gmelodie/fire-lora-heltec/figures/deployment_map.png

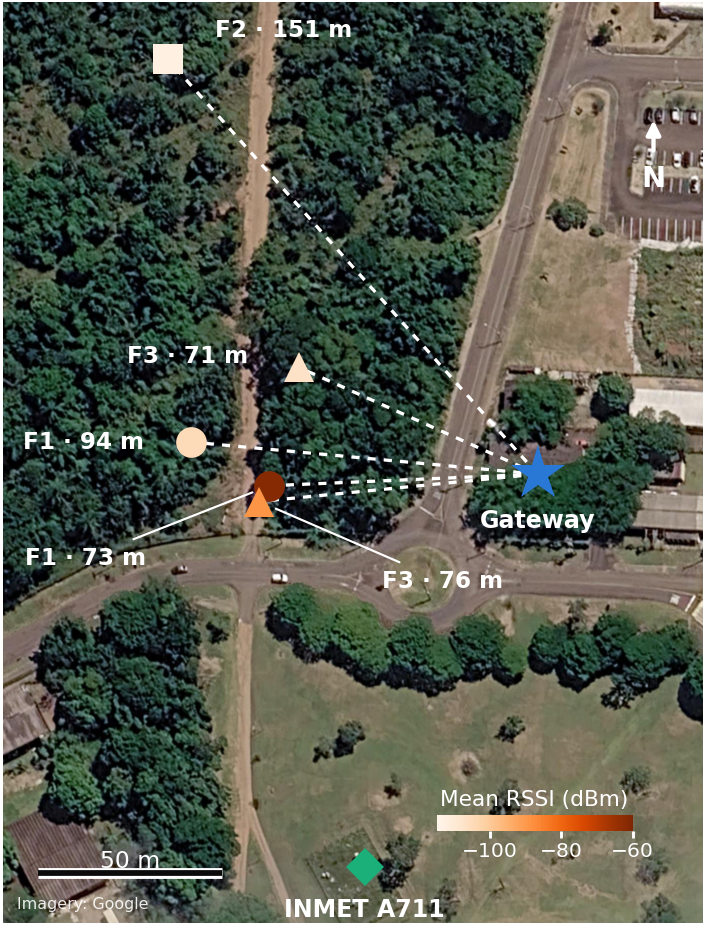
figures/deployment_map.png
