gmelodie/fire-lora-heltec/figures/battery_discharge.png

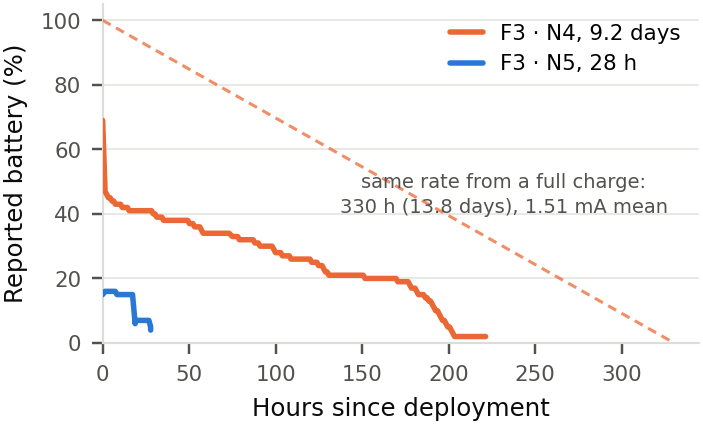
figures/battery_discharge.png
