gmelodie/fire-lora-heltec/figures/condensation_cycle.png

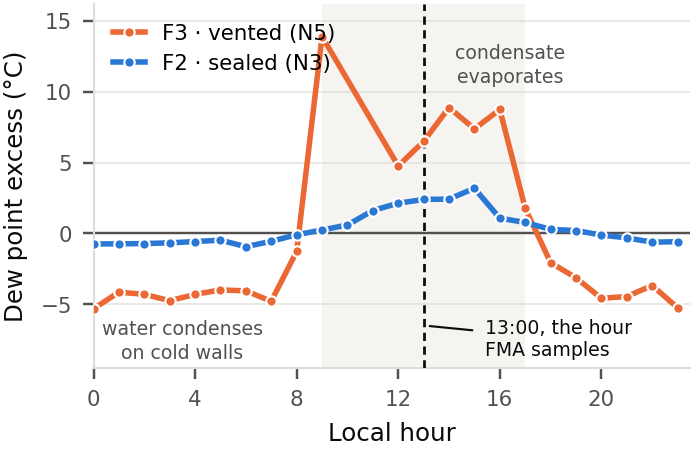
figures/condensation_cycle.png
