gmelodie/fire-lora-heltec/figures/fma_season.png

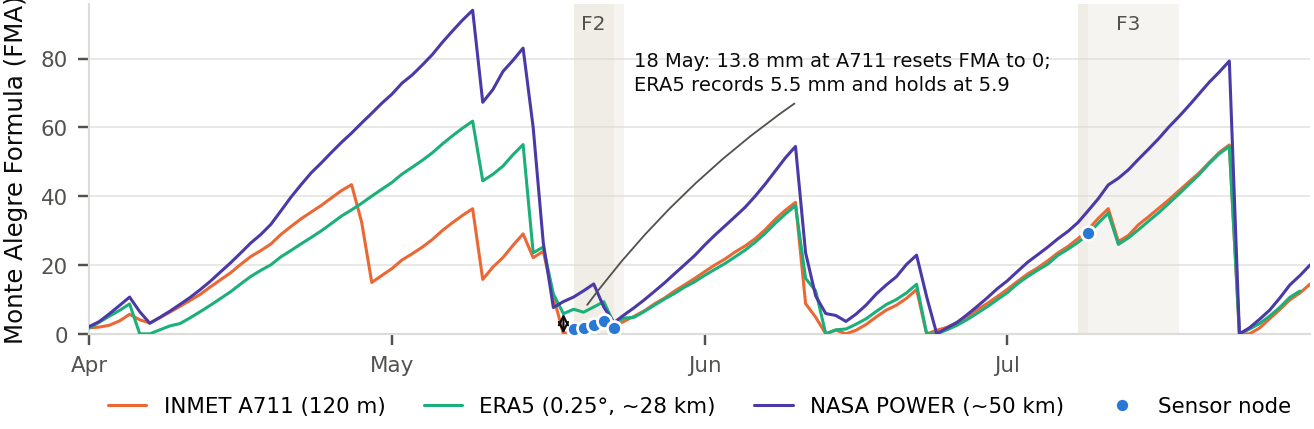
figures/fma_season.png
