gmelodie/fire-lora-heltec/figures/index_ladder.png

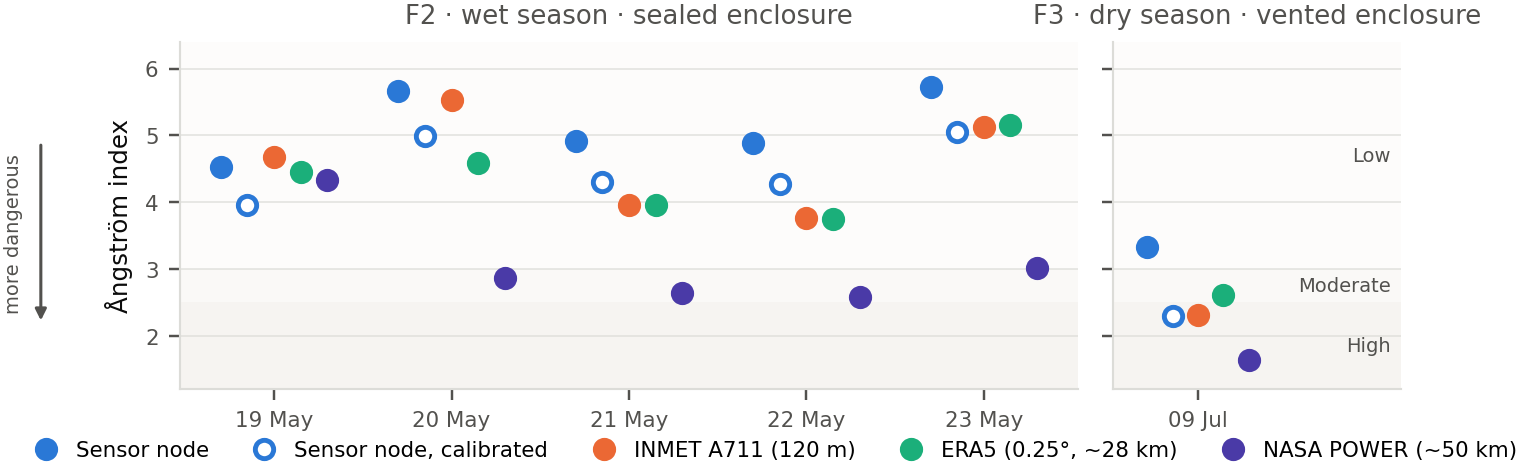
figures/index_ladder.png
