gmelodie/fire-lora-heltec/figures/link_budget.png

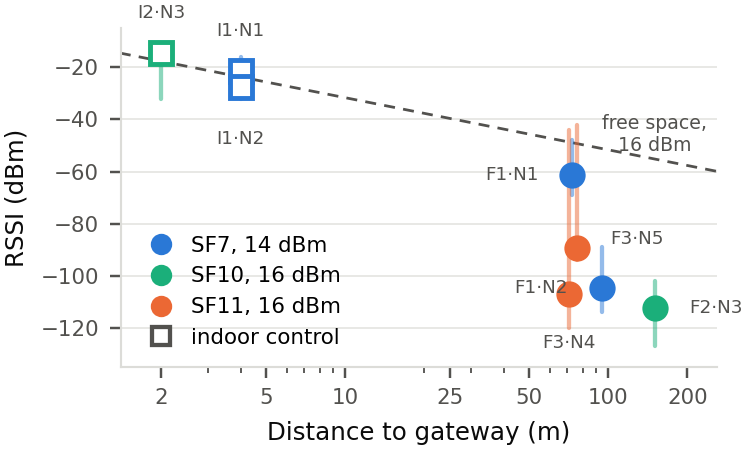
figures/link_budget.png
