gmelodie/fire-lora-heltec/(commit log)

2026-02-28 add battery module
2026-03-01 chore: update to v3 board
2026-03-17 fix(sensor): fix battery reading
    - Swap voltage formula for empirical ADC thresholds
    - Add BAT_100..BAT_DEAD and NUM_ADC_SAMPLES to settings.h
    - Changed BATTERY_PIN 17 -> 1
    [sensor.ino, settings.h]
2026-03-17 fix(sensor): fix BME280 I2C initialization
    - Use Wire1 to avoid conflict with OLED on default Wire bus
    - Add BME_SDA (4) and BME_SCL (3) to settings.h
    - Pass &Wire1 to bme.begin()
    [sensor.ino, settings.h]
2026-03-17 refactor(api): merge battery and sensor data into single table
    - Drop battery_readings table, add battery column to readings
    - Remove /battery endpoint and insert_battery()
    - Handle nil fields gracefully (store as NULL)
    - Add GET /readings endpoint returning last 10 rows
2026-03-17 fix(gateway/sensor): reliability fixes and API integration - sensor: add 100ms delay before startReceive() after TX - Fix wifiConnected shadowing in setup() and maintainWiFi() - Switch to ISR-based r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
    [gateway.ino, sensor.ino, settings.h]
2026-03-21 feat: introduce BATTERY_AVAILABLE compile-time flag
2026-03-23 fix: add delay between adc reads for consistency
    [sensor.ino]
2026-03-23 fix: new readings for adc with voltage divider (r1 = 30k; r2 = 10k)
    [settings.h]
2026-03-23 feat: Uart connection to orange pi, that handles api posts to server
2026-03-29 feat. time awake samples collection
2026-04-22 chore: use esp32 even on eduroam
2026-04-26 show battery upon sensor boot
2026-04-26 fix: sleep counter overflow
    [sensor.ino, settings.h]
2026-04-26 fix: properly parse api_url
    [gateway.ino]
2026-04-27 chore: make sensor default to battery available
2026-04-27 fix: working eduroam connect
    [gateway.ino]
2026-04-28 feat: calculate sensor battery
2026-04-30 feat: exponential backoff on sensor missing
    [sensor.ino, settings.h]
2026-04-30 chore: pass sensor id
2026-04-30 fix: dont wakup screen at every wakup from sleep (only at first boot ever)
    [sensor.ino]
2026-05-01 chore: add --camera flag to recompile script
2026-05-01 chore: account for v3.2 and v3 when calculating heltec battery
2026-05-09 chore: better v3.2 battery readings
2026-05-09 Fix: Higher POWER_DBM
    The increase in battery use is negligible, and it increases reach.
    [settings.h]
2026-05-15 fix: better battery handling
    [sensor.ino, settings.h]
2026-05-18 fix: startReceive called before data (gw stuck)
    [gateway.ino, sensor.ino, settings.h]
2026-05-27 chore: better battery usage and readings
